makgtrt06/AMON/Hardware/Captura de pantalla 2023-05-22 110352.jpg

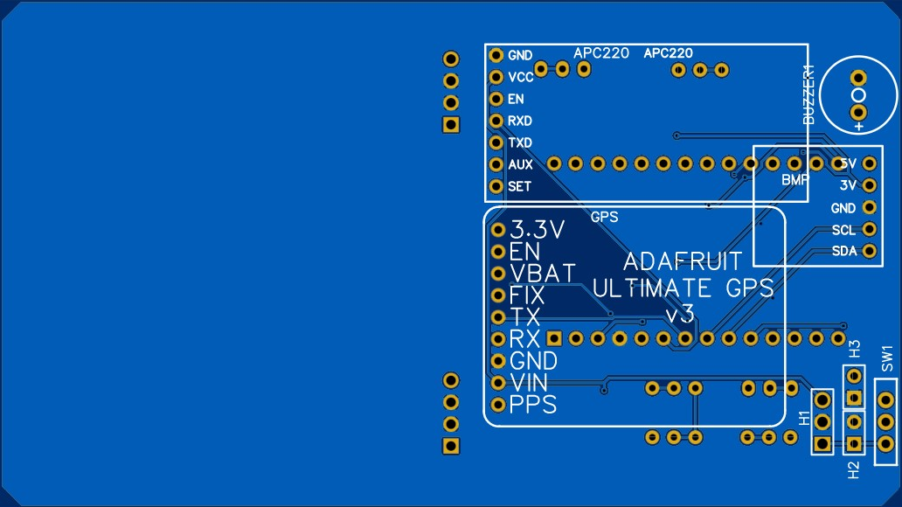
Hardware/Captura de pantalla 2023-05-22 110352.jpg
