makgtrt06/AMON/Software/Diagrama circuit i codi.png

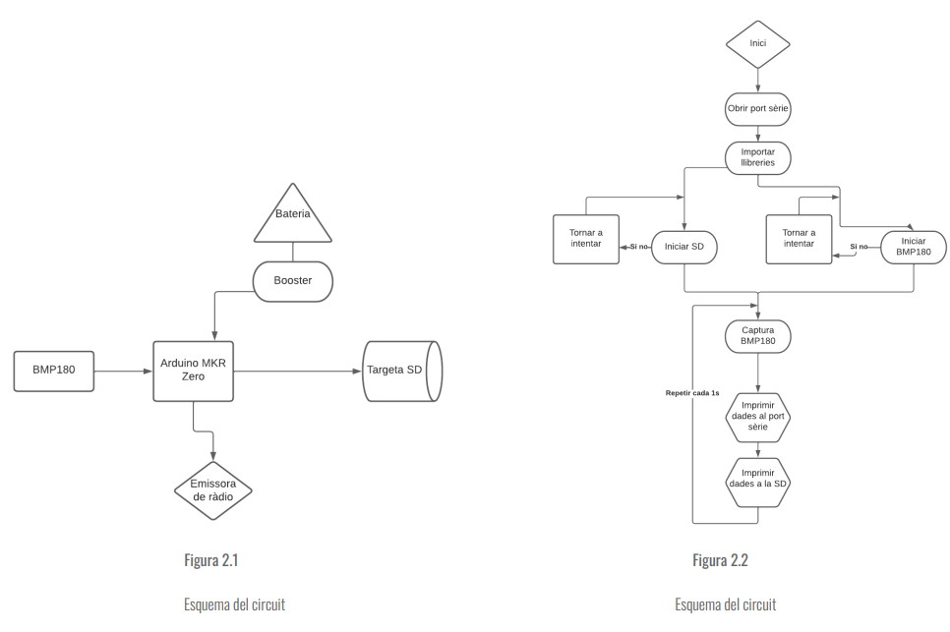
Software/Diagrama circuit i codi.png
