makgtrt06/AMON/Hardware/Schematic.pdf

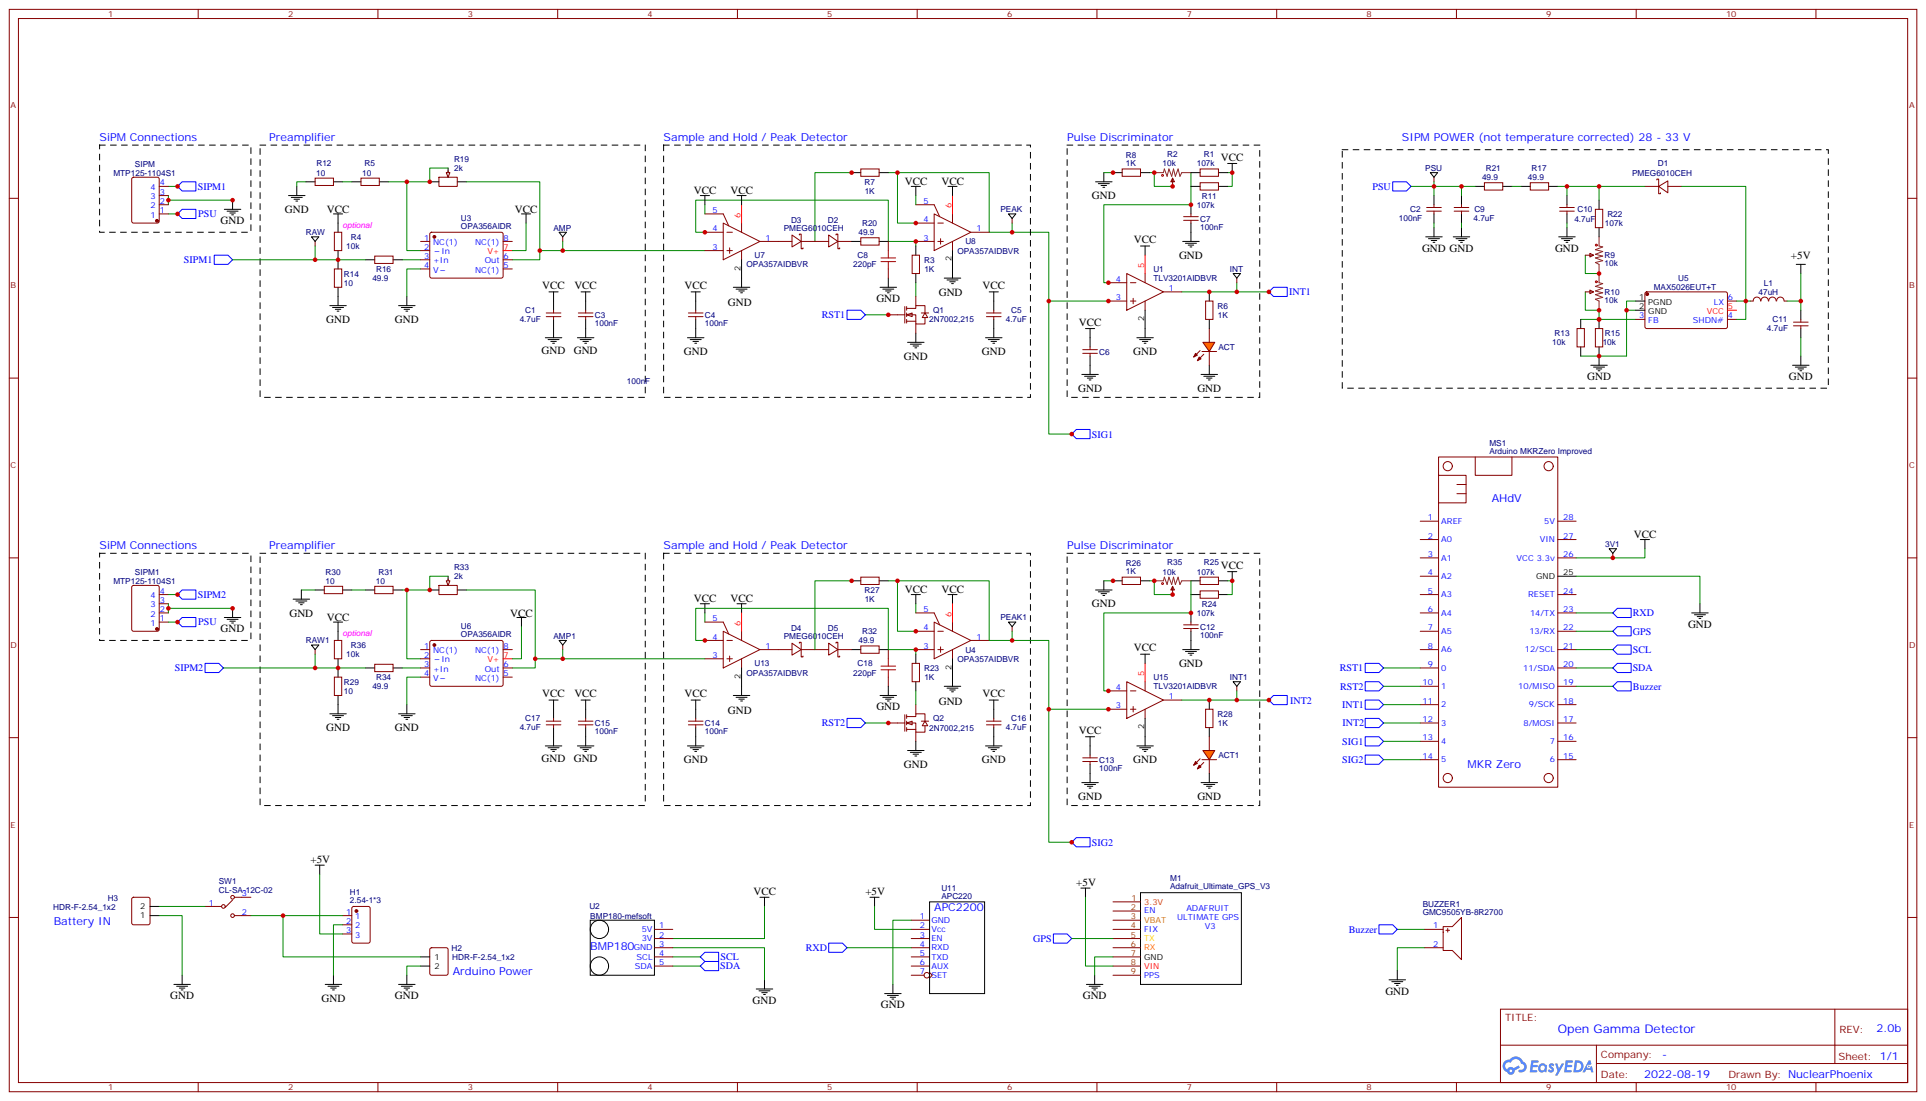
[picture p6: page 1]

Sample and Hold / Peak Detector
